Livelinndy/PeiP2_Arduino_CuriousCar/(commit log)

2018-01-11 Create LydiaBARAUKOVA.md
    Cahier de suivi de projet
2018-01-19 Create driver
